LouisFSegalla/Interface-para-testes-em-motores-CC/InterfaceGrafica/main.cpp

#include "mainwindow.h"
#include "motor.h"

#include <iostream>
#include <fstream>

using namespace std;

#include <QApplication>

int main(int argc, char *argv[])
{
    QApplication a(argc, argv);
    MainWindow w;
    w.show();

    return a.exec();
}
